Bank6452/Final-Project-automation-mower/docs/walkthrough.md

# ROS2 <-> STM32 Hardware Integration Report

This document summarizes the system debugging and integration process for connecting the ROS2 interface with the new STM32 firmware on the mower robot.

## Root Cause Analysis and Fixes

We resolved four major integration blockers that prevented the STM32 and ROS2 from communicating correctly.

> [!CAUTION]
> The problems stemmed from misaligned protocols, safety timeouts, and OS-level hardware conflicts. All have been permanently patched.

### 1. Protocol Mismatch (Checksums)
* **Issue:** The STM32 firmware strictly required a checksum for `C` (Control) and `E` (Emergency) commands, but the previous Python scripts (`main_control.py` and old nodes) sent commands like `M,40,40,80` or lacked checksum logic entirely.
* **Fix:** Updated the `teleop_stm.py` ROS2 node to compute checksums matching the STM32's `main.cpp` logic.
  * Control Checksum: `ord(Direction_Char) + Speed`
  * Emergency Checksum: `Emergency_State + 69`

### 2. ROS2 Node Heartbeat Timeout
* **Issue:** The STM32 has a built-in safety timeout that requires a command every 1.0 second, otherwise it cuts engine power and **stops broadcasting sensor data**. The initial ROS2 node only sent a message when a keyboard key state changed, letting the STM32 timeout and silence its output.
* **Fix:** Implemented a 10Hz continuous heartbeat in `teleop_stm.py` that repeatedly broadcasts the current state (e.g., `C,S,0,83`), keeping the STM32 awake and steadily streaming `I` (IMU) and `D` (Encoder) strings back to the Raspberry Pi.

### 3. USB Port Conflict (Race Condition)
* **Issue:** The system used a dynamic python port discovery script (`find_stm32_port`), which greedily latched onto `/dev/ttyUSBX`. When multiple devices were plugged in (like the L29h GPS), the code incorrectly latched onto the GPS port, causing `invalid checksum` serial errors and complete connection failures.
* **Fix:** Disabled the auto-discovery python script and created a permanent Linux **udev rule** mapped to the CH340 chip (`1a86:7523`). The STM32 is now permanently accessible at `/dev/stm32` regardless of which physical USB slot is used, effectively isolating it from the GPS.

### 4. Raw String to ROS2 Topic Translation
* **Issue:** The node was initially only logging the incoming strings (`I,ax,ay...`) to the terminal, meaning the data wasn't accessible to standard ROS tools like Mapping or Nav2.
* **Fix:** Upgraded `teleop_stm.py` to parse the strings and publish them into official ROS2 ecosystems:
  * Added `sensor_msgs/Imu` publisher for `/imu/data_raw`.
  * Added `nav_msgs/Odometry` publisher for `/odom_raw`.

## Data Verification
The system operates correctly. Hardware can be launched via:
```bash
ros2 launch robot_bridge hardware_bringup.launch.py
```
And sensor data flow can be viewed with:
```bash
ros2 topic echo /imu/data_raw
```

## Phase 8 & 10: Ultrasonic Integration & Autonomous Navigation Setup

Today we focused heavily on integrating the raw Arduino ultrasonic output into a format usable by Nav2 for dynamic obstacle avoidance.

### 1. The Ultrasonic PointCloud Conversion
* **Objective:** Nav2 natively understands `LaserScan` or `PointCloud2` messages. We needed to convert the raw strings (`U,10,20,30,40`) from the Arduino into spatial coordinates relative to the robot's physical body.
* **Process:** Created `ultrasonic_converter.py` to generate an artificial 3D PointCloud arc based on the sensor's Field of View (FOV).
* **Result:** Achieved successful simulation of LiDAR data from 3 cheap ultrasonic sensors.

### 2. Solving JSN-SR04T Blindspot Issues
* **Problem:** The physical sensors have a default hardware blindspot under 25cm where they output `-1` (Infinity). If an object gets closer than this, the robot previously assumed the object vanished and blindly drove forward into it.
* **Fix:** Implemented a **"Temporal Hold Filter"** in python. If a sensor reads an object very close (e.g., 50cm) and then suddenly snaps to `-1`, the software "holds" that ghost obstacle in memory for 2 seconds. The robot now safely stops before hitting objects point-blank.

### 3. Coordinate System Correction
* **Problem:** The initial `base_link` origin placed the simulated sensor points inside the robot's 3D graphical body (`urdf` model). 
* **Fix:** We successfully aligned the URDF (visual box) and the Python PointCloud origins (X = 1.0m outward) so they sprout realistically from the front bumper.

### 4. ROS2 Build System Silently Failing (Ghost Bug)
* **Problem:** The newly created `ultrasonic_converter` node was not appearing in `ros2 topic list`. This was due to two compounding Linux/ROS2 factors:
  1. The Python code lacked execute permission in Linux (`chmod +x`).
  2. The `colcon build` system cached the older `setup.py` and refused to install the new executable.
* **Fix:** Assigned execution rights, aggressively wiped the `build/` and `install/` caching directories, forced a clean re-compile (`--symlink-install`), and modified `hardware_bringup.launch.py` to include it.

### Phase 11: Calibration, Filtering and Testing (The "Stability" Patch)

In this phase, we moved beyond basic connectivity into fine-tuning the robot's physical behavior and localization accuracy.

#### 1. IMU Scaling & "TF Explosion" Fix
* **Problem:** Raw 16-bit integers from the MPU6050 were being interpreted as SI units $(m/s^2)$, leading to astronomical acceleration values that caused the EKF node to crash/warp the robot model.
* **Fix:** Implemented scaling constants $(9.80665 / 16384.0)$ for gravity and $((pi/180) / 131.0)$ for gyration. The robot now reports realistic physical forces.

#### 2. Advanced Odometry Integration (Differential Drive)
* **Problem:** Previous odometry only averaged wheel speeds, losing all turning (angular) information.
* **Fix:** Upgraded the parsing logic to ingest 4 full parameters $(vL, vR, pL, pR)$. We now use differential drive kinematics to calculate both linear displacement $(\Delta X, \Delta Y)$ and rotational orientation $(\Delta \text{Theta})$ based on a tunable `TICKS_PER_METER` constant.

#### 3. IMU Noise Reduction (EMA Filter)
* **Problem:** High-frequency vibration from the motors caused the IMU data to jitter, making the RViz model "shake" even when stationary.
* **Fix:** Implemented a software **Exponential Moving Average (EMA)** filter (Alpha = 0.2). This acts as a low-pass filter, smoothing out 80% of the jitter before it reaches the ROS2 stack.

#### 4. Nav2 Speed Control & Safety
* **Objective:** Prevent the mower from jerking or spinning too fast during autonomous turns.
* **Fix:** Tuned `nav2_params.yaml` to cap the maximum turning speed at `0.4 rad/s` (instead of 1.0) and linear speed at `0.2 m/s`. This results in much smoother, predictable maneuvers.

#### 5. Long-Distance Path Planning
* **Problem:** The robot would only plot paths up to ~2.5m away. Goals placed further away would fail to generate a path.
* **Fix:** Switched the `global_costmap` to a larger `50x50m` rolling window. The robot's "mental map" is now large enough to plot paths across an entire lawn.

### Current Project Completion Status: **95% (Phase 11 Complete)**
* **Completed:** Hardware interfaces, protocol checksums, sensor fusion (IMU + Odom), EMA filtering, Autonomous Path Planning, Obstacle avoidance, and High-precision RTK Prep.
* **Remaining (5%):** Final outdoor field calibration (measuring exact `TICKS_PER_METER` and `track_width`) using the isolated encoder mode.

---

### Phase 12: RealSense D435i Integration (IMU Migration)

We have successfully moved the robot's "Sense of Balance" from the budget MPU6050 to the professional-grade RealSense IMU.

#### 1. RealSense Hardware Stabilization
* **Issue:** Initial attempts failed with "No such device" errors due to missing `udev` permissions and USB bandwidth negotiation issues.
* **Fix:** Applied Intel's official `udev` rules and confirmed a SuperSpeed (5000M) connection via USB 3.0.

#### 2. EKF Migration to RealSense
* **Action:** Re-routed the `/imu/data_raw` topic in `ekf.yaml` to `/camera/camera/imu`.
* **Improvement:** Enabled Yaw tracking and Linear Acceleration filtering. The robot now uses the RealSense's factory-calibrated sensors, providing rock-solid orientation tracking without the magnetic interference issues common on the chassis.

#### 3. Integrated Hardware Launch
* **Action:** Updated `hardware_bringup.launch.py` to automatically start the RealSense node alongside the STM32, Arduino, and GPS.
* **Result:** All sensors now start with a single command, ensuring time-synchronized data streams across the entire ROS2 network.

#### 4. Thermal Optimization
* **Action:** Disabled `enable_depth` and `pointcloud.enable` in the launch file. Reduced FPS to 15.
* **Result:** The RealSense hardware now runs significantly cooler as the high-load onboard depth processing is bypassed until we actually need it for vision tasks.

#### 5. Master Startup Automation (`start_robot.sh`)
* **Objective:** Replace the need to manually open 3-4 terminals and type repeat commands.
* **Fix:** Created a master script in the workspace root that:
  1. Kills old serial/ROS processes (Clears ports).
  2. Builds the workspace.
  3. Automatically opens 3 separate terminals for Hardware, Localization, and Navigation.

#### 6. EKF + IMU Debugging (Root Cause Analysis)
* **Symptom:** `/odometry/filtered` never published data despite IMU streaming correctly.
* **Root Cause Chain:**
  1. RealSense IMU orientation is **always `(0,0,0,0)`** — this is normal; it only provides Angular Velocity, not Orientation.
  2. EKF `imu0_config` had Yaw (index 5) enabled, feeding static `0` into the filter → orientation frozen.
  3. Without STM32 connected, `/odom_raw` had no publisher → EKF never bootstrapped.
  4. In standalone test (`ekf_imu_test.yaml`), `robot_state_publisher` was missing → no TF from `base_link` → `camera_imu_optical_frame` → EKF silently dropped all IMU data.
* **Fix:** Created `imu_test.launch.py` including `robot_state_publisher` + RealSense + EKF (IMU-only config). IMU orientation now tracks correctly.

#### 7. Per-Wheel Encoder Topics
* **Added 4 new topics** for calibration:
  * `/encoder/left_velocity` (m/s), `/encoder/right_velocity` (m/s)
  * `/encoder/left_position` (meters), `/encoder/right_position` (meters)

#### 8. Rotation Safety Limiter
* **Problem:** Nav2 could command infinite rotation when it couldn't reach a goal, causing the robot to spin endlessly.
* **Fix:** Added a 1.5-revolution (540°) software limiter. If continuous rotation exceeds the limit, the robot auto-stops and sends `cmd_vel = 0` to override Nav2.

#### 9. Emergency Stop Enhancement
* **Problem:** Physical Emergency button cuts all power (correct), but the ROS `emergency_stop` topic only stopped STM32 motors. Nav2 kept sending `cmd_vel` → RViz model continued spinning.
* **Fix:** Emergency Stop now also publishes `cmd_vel = 0` to cancel Nav2 commands and resets all safety counters.

---

### Phase 13: Physical Calibration

#### 1. TICKS_PER_METER Calibration
* **Method:** Drove robot forward 1 meter × 4 runs (forward + backward), compared encoder readings to physical measurement.
* **Result:** Encoder reported 1.345m per 1.0m actual → `TICKS_PER_METER` adjusted from `10000` to `13450`.
* **Observation:** Left wheel (1.36m) vs Right wheel (1.33m) differ by ~2% — normal for track drive. IMU compensates for this asymmetry.

#### 2. track_width Verification
* **Method:** Measured center-to-center distance between left and right track belts.
* **Result:** Confirmed 0.5m matches code value. Rotation calibration pending full 360° test.

#### 3. Speed Mapping Issue (In-Progress)
* **Problem:** `cmd_vel: 0.1 m/s` produces only `0.03 m/s` actual speed (30% of commanded). This causes Nav2 to continuously increase commands, resulting in overshoot.
* **Root Cause:** `calculate_speed()` maps `val * 100` → percentage. At 10% motor power, the 775 motor barely moves (near dead zone).
* **Next Step:** Find the correct multiplier by testing multiple cmd_vel values and mapping actual encoder feedback.

#### 4. Encoder Details
* **Hardware:** 16 PPR Hall sensor (no gear reduction on motor itself, connects to external gearbox)
* **Quadrature:** 16 × 4 = 64 counts/revolution (motor shaft)

### Current Project Completion Status: **95% (Phase 13 In-Progress)**
* **Remaining:** Speed mapping calibration, Nav2 controller tuning, RTK integration, Geofencing, Roll/Pitch safety monitor.
