Bank6452/Final-Project-automation-mower/src/mower_bot_description/meshes/Car.stl

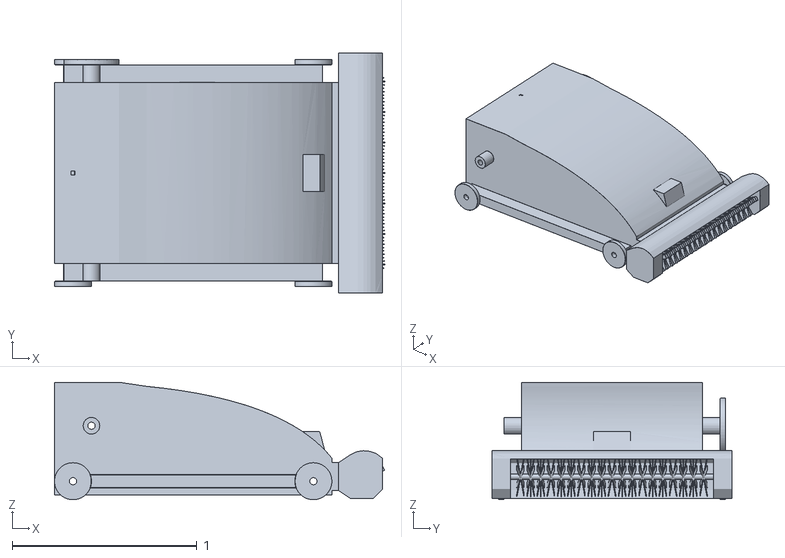
[picture p2: CAD file, 2026-03-14]
src/mower_bot_description/meshes/Car.stl
1.78 x 1.30 x 0.635
