Bank6452/Final-Project-automation-mower/src/mower_bot_description/meshes/coordi_sys_wheel_right_Link.STL

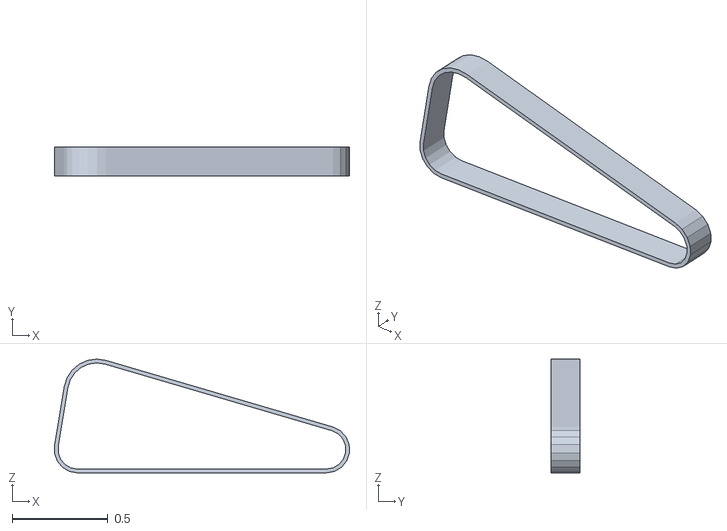
[picture p3: CAD file, 2026-03-14]
src/mower_bot_description/meshes/coordi_sys_wheel_right_Link.STL
1.54 x 0.15 x 0.595
