Bank6452/Final-Project-automation-mower/src/mower_bot_description/meshes/coordi_sys_chassis_center_Link.STL

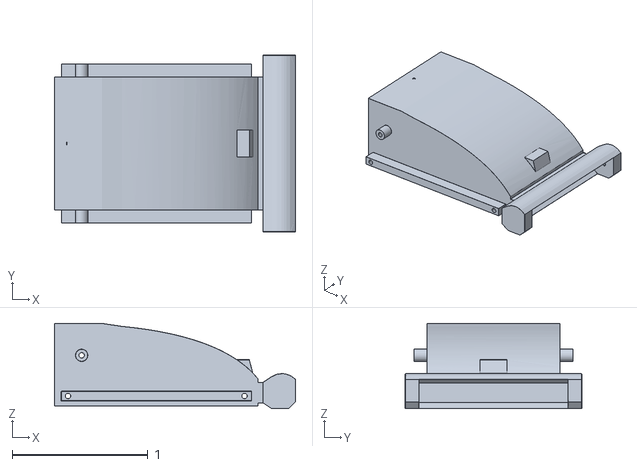
[picture p4: CAD file, 2026-03-14]
src/mower_bot_description/meshes/coordi_sys_chassis_center_Link.STL
1.77 x 1.30 x 0.628
