Bank6452/Final-Project-automation-mower/(list of files, cad)

Other CAD files:
src/mower_bot_description/meshes/Car2.stl
src/mower_bot_description/meshes/coordi_sys_wheel_left_Link.STL
