Bank6452/Final-Project-automation-mower/docs/frames/frames_2026-03-12_07.49.53.pdf

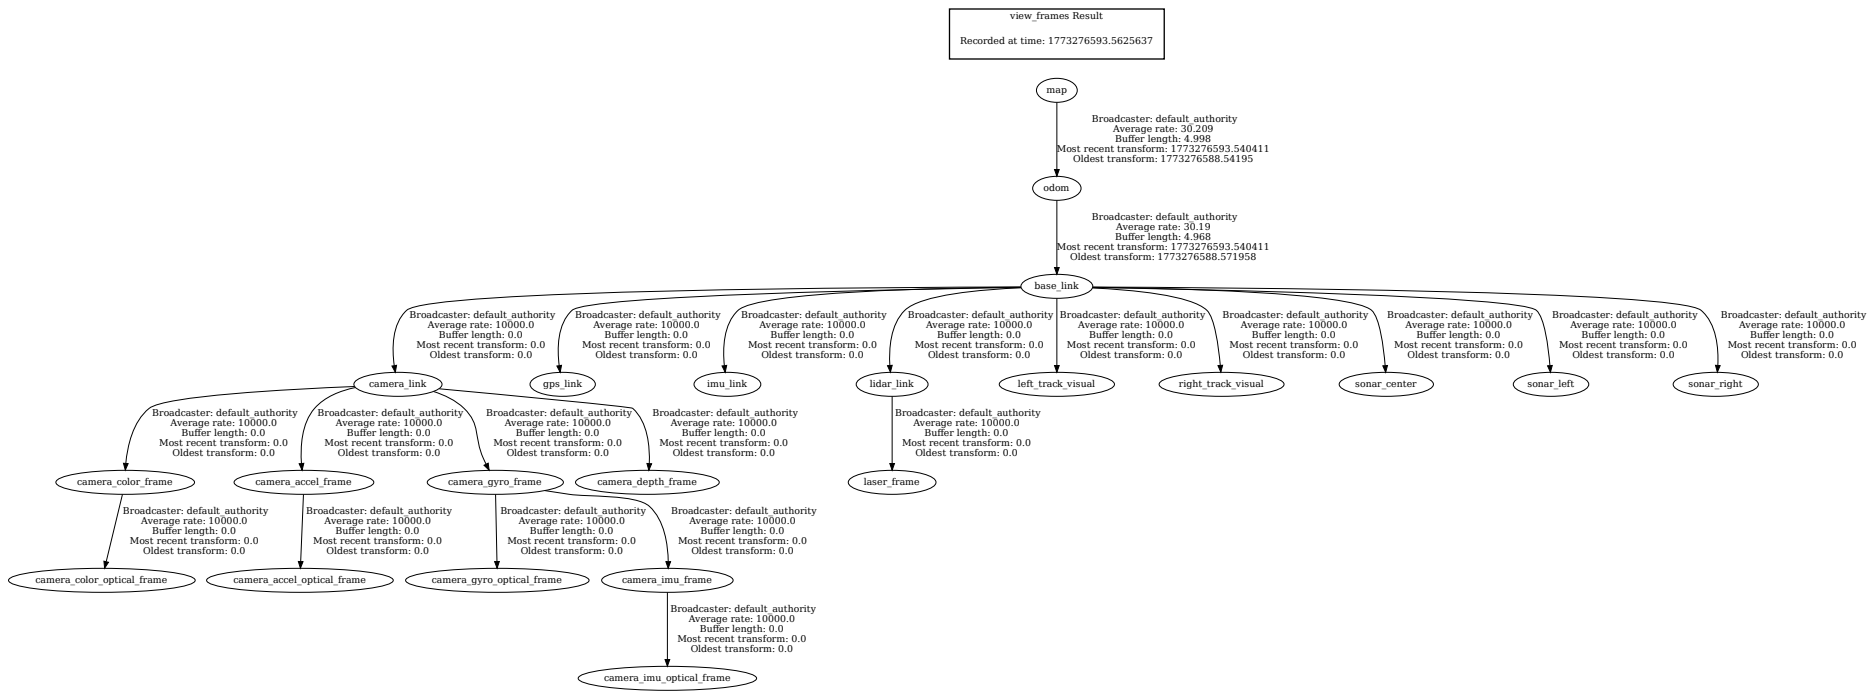
[picture p5: page 1]
view_frames Result; odom; base_link; Broadcaster: default_authority Average rate: 30.19 Buffer length: 4.968; camera_link; gps_link; imu_link; lidar_link; left_track_visual; right_track_visual; sonar_center; sonar_left; sonar_right; map; Broadcaster: default_authority Average rate: 30.209 Buffer length: 4.998; camera_color_frame; camera_accel_frame; camera_gyro_frame; camera_depth_frame; camera_color_optical_frame; camera_accel_optical_frame; camera_gyro_optical_frame; camera_imu_frame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

Recorded at time: 1773276593.5625637

Most recent transform: 1773276593.540411
Oldest transform: 1773276588.54195

Oldest transform: 1773276588.571958

Broadcaster: default_authority
Average rate: 10000.0
Buffer length: 0.0
Most recent transform: 0.0
Oldest transform: 0.0
