Bank6452/Final-Project-automation-mower/docs/frames/frames_2026-03-12_08.09.06.pdf

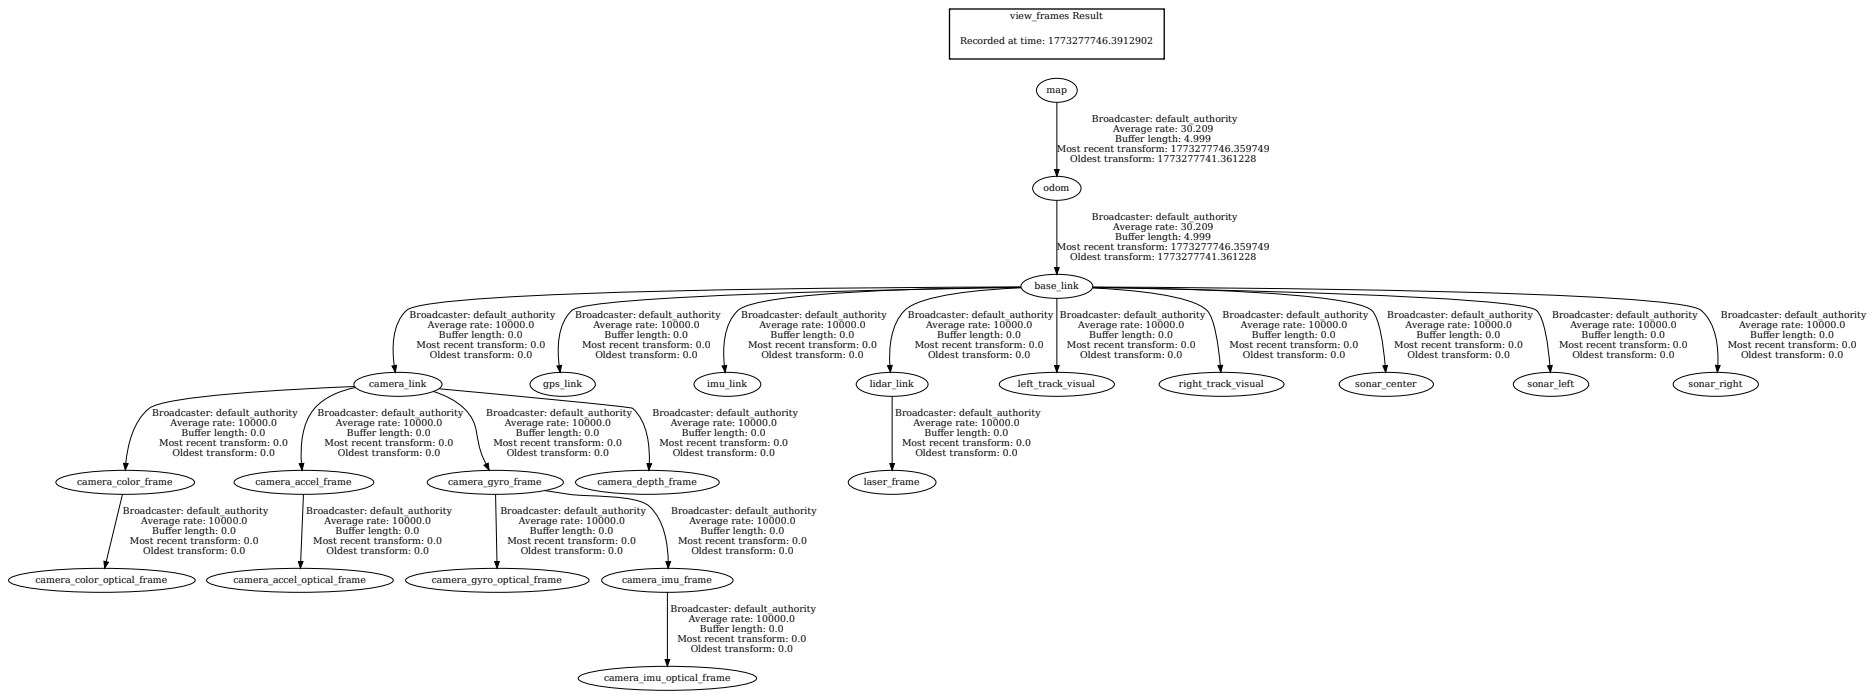
[picture p6: page 1]
view_frames Result; camera_link; camera_color_frame; camera_accel_frame; camera_gyro_frame; camera_depth_frame; camera_color_optical_frame; base_link; gps_link; imu_link; lidar_link; left_track_visual; right_track_visual; sonar_center; sonar_left; sonar_right; camera_accel_optical_frame; camera_gyro_optical_frame; camera_imu_frame; camera_imu_optical_frame; odom; Broadcaster: default_authority Average rate: 30.209 Buffer length: 4.999; laser_frame; map

Recorded at time: 1773277746.3912902

Most recent transform: 1773277746.359749
Oldest transform: 1773277741.361228

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
