Bank6452/Final-Project-automation-mower/docs/frames/frames_2026-03-13_12.51.19.pdf

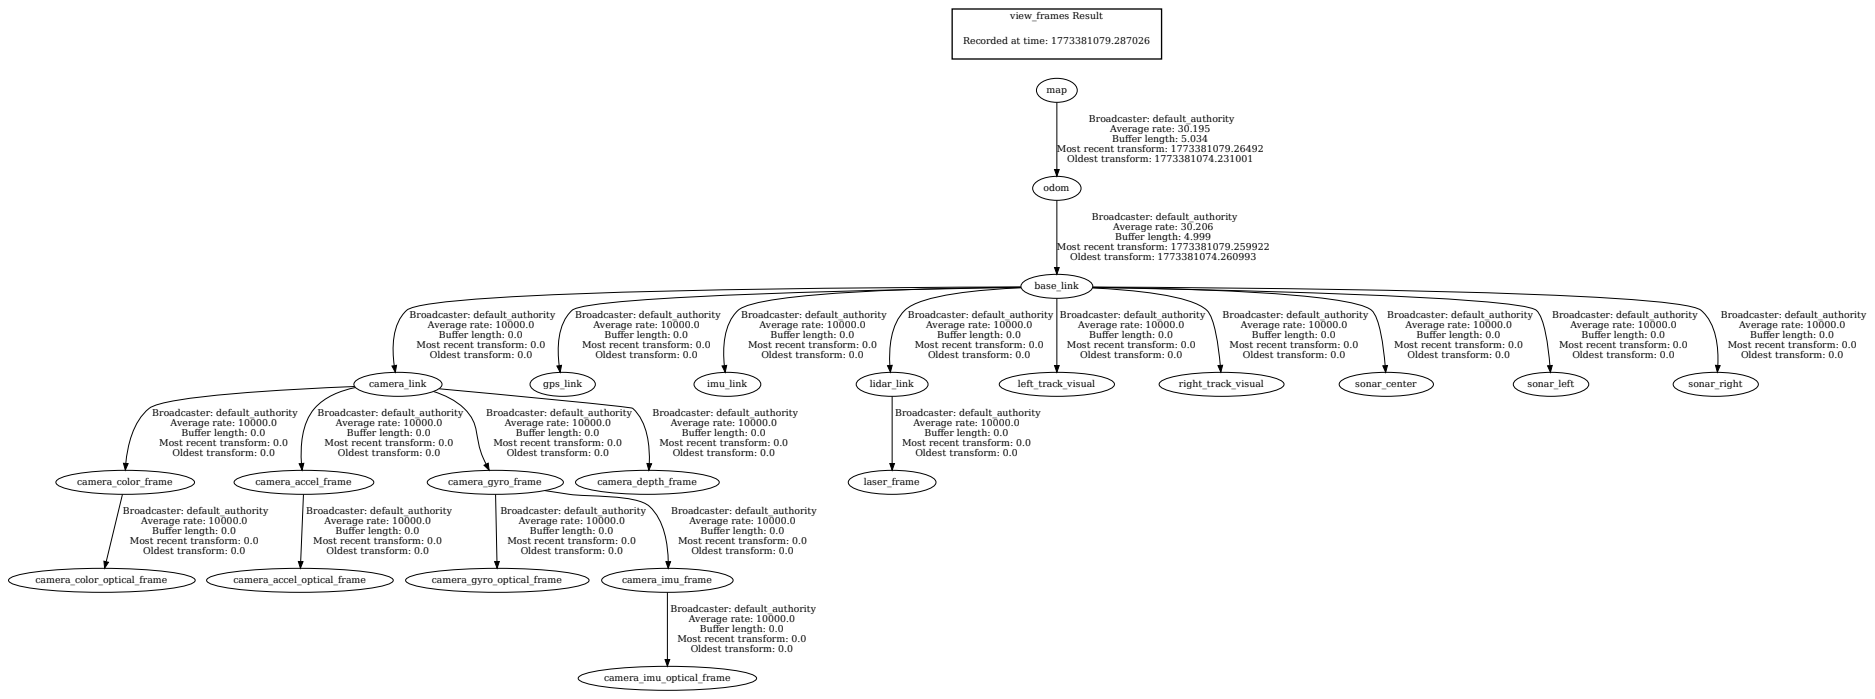
[picture p7: page 1]
view_frames Result; odom; base_link; Broadcaster: default_authority Average rate: 30.206 Buffer length: 4.999; camera_link; gps_link; imu_link; lidar_link; left_track_visual; right_track_visual; sonar_center; sonar_left; sonar_right; map; Broadcaster: default_authority Average rate: 30.195 Buffer length: 5.034; camera_color_frame; camera_accel_frame; camera_gyro_frame; camera_depth_frame; camera_color_optical_frame; camera_accel_optical_frame; camera_gyro_optical_frame; camera_imu_frame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

Recorded at time: 1773381079.287026

Most recent transform: 1773381079.26492
Oldest transform: 1773381074.231001

Most recent transform: 1773381079.259922
Oldest transform: 1773381074.260993

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
