Bank6452/Final-Project-automation-mower/(commit log)

2026-03-14 Initial commit: mower robot ROS2 workspace
    - src/: ROS2 packages (mower_bot_description, robot_bridge)
    - firmware/: STM32 PlatformIO project + Arduino ultrasonic
    - docs/: notes, TF frames, walkthrough
    - tools/: launch scripts, debug URDF
    - assets/: AI/YOLO code, PWM test data
    [Car.stl, Car2.stl, coordi_sys_chassis_center_Link.STL, coordi_sys_wheel_left_Link.STL, coordi_sys_wheel_right_Link.STL, debug_color.urdf, debug_robot.urdf, mower_core.xacro]
2026-03-17 Add Docker build setup for Raspberry Pi
